madcatse/IBM-Model-H/modelh-main/site/bare_pcb.jpg

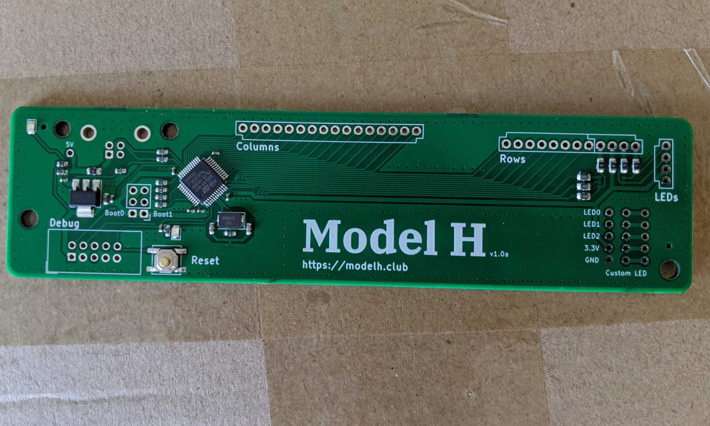
modelh-main/site/bare_pcb.jpg
