madcatse/IBM-Model-H/modelh-main/site/box_on_keyboard.jpg

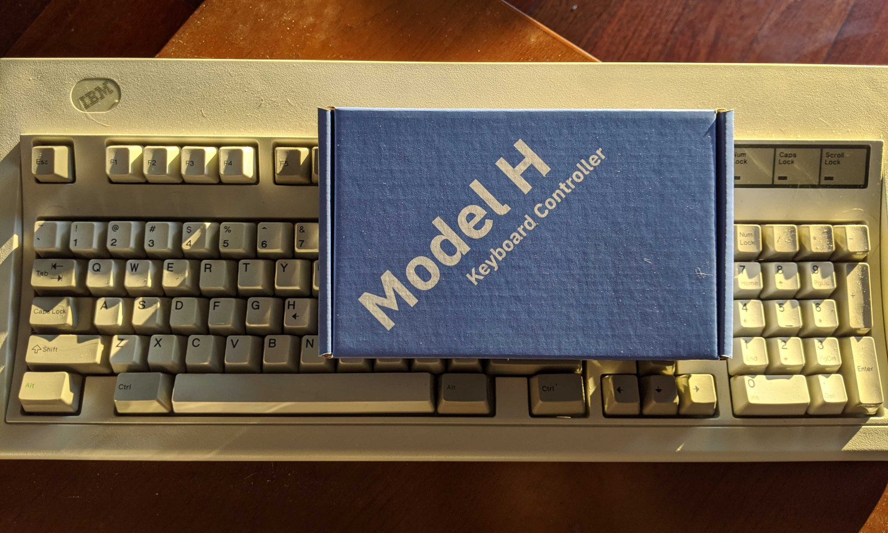
modelh-main/site/box_on_keyboard.jpg
