madcatse/IBM-Model-H/modelh-main/site/modelh_usb_back.jpg

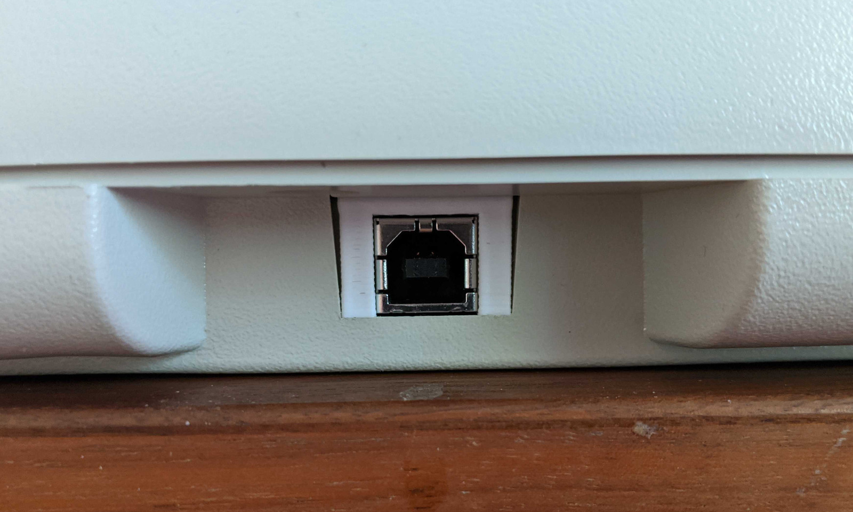
modelh-main/site/modelh_usb_back.jpg
