madcatse/IBM-Model-H/modelh-main/shim/shim.stl

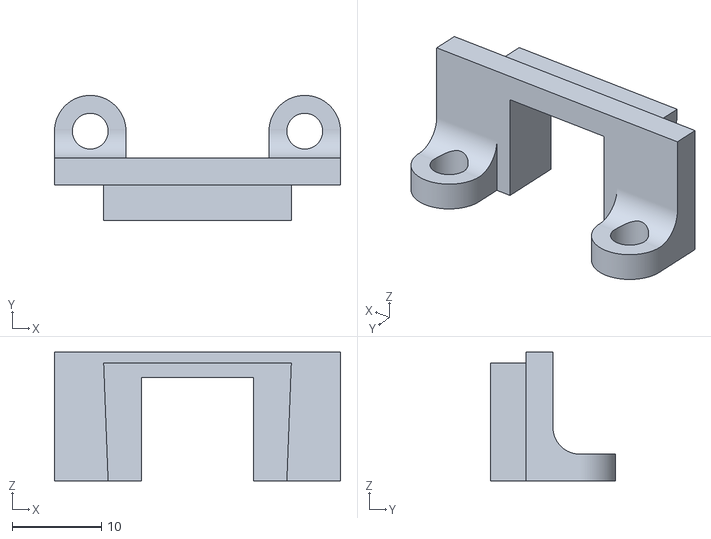
[picture p10: CAD file, 2024-10-23]
modelh-main/shim/shim.stl
32.0 x 14.0 x 14.4
