madcatse/IBM-Model-H/(list of files, cad)

Other CAD files:
modelh-main/shim/shim.scad
