madcatse/IBM-Model-H/modelh-main/pcb/modelh.kicad_pcb

## KiCad design modelh-main/pcb/modelh.kicad_pcb (2024-10-23)

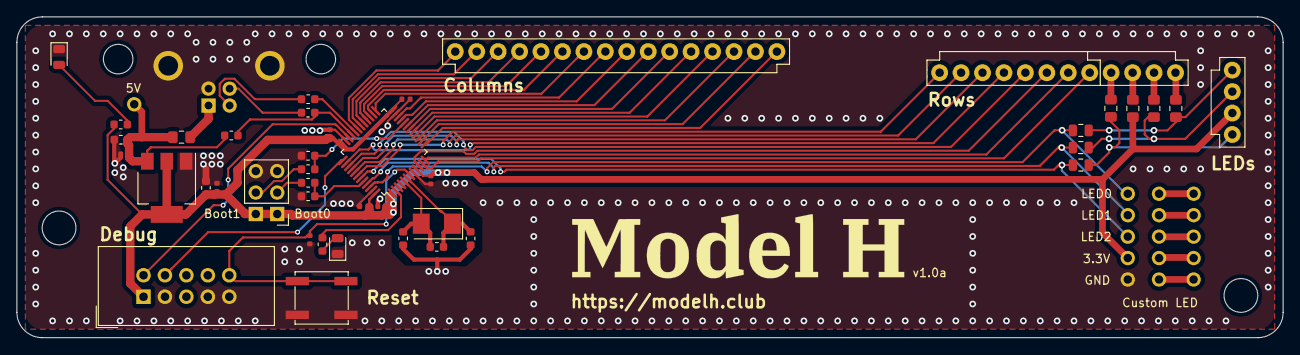
[picture p11: board modelh.kicad_pcb from above]

Board: 2 copper layers, 150.0 x 38.0 mm, 46 parts (0 on the bottom side), 59 nets.

Parts:
C1, C3: 10uF; C_0603_1608Metric
C2, C4, C9, C10, C11, C12, C13, C14: 100nF; C_0402_1005Metric
C5, C6: 20pF; C_0603_1608Metric
J1: USB_B; USB_B_OST_USB-B1HSxx_Horizontal
J2: Conn_cols; ModelH-triomate-cols16
J3: Conn_rows; ModelH-triomate-rows12
J4: Conn_leds; ModelH-tripmate-leds4
J5: Conn_02x03_Odd_Even; PinHeader_2x03_P2.54mm_Vertical
J6: Conn_02x05_Odd_Even; IDC-Header_2x05_P2.54mm_Vertical
J7, J8, J9: Conn_01x05; PinSocket_1x05_P2.54mm_Vertical
LED1, LED2: green; LED_0805_2012Metric
R1, R2: 330; R_0603_1608Metric
R3, R4: 22; R_0603_1608Metric
R5, R10, R11: 1.5k; R_0603_1608Metric
R6: 1M; R_0603_1608Metric
R7, R8, R9: 100; R_0805_2012Metric
R12, R13, R14, R15, R16: 0; R_0805_2012Metric_Pad1.15x1.40mm_HandSolder
R17, R18: 100k; R_0603_1608Metric
SW1: SW_Push; SW_SPST_EVPBF
TP1: TestPoint; TestPoint_THTPad_D1.5mm_Drill0.7mm
U1: STM32F103C8Tx; LQFP-48_7x7mm_P0.5mm
U2: AMS1117-3.3; SOT-223-3_TabPin2
Y1: 8MHz; Crystal_SMD_5032-2Pin_5.0x3.2mm

Connections:
+3V3: C3.1, C4.1, C10.1, C11.1, C12.1, C13.1, C14.1, J4.3, J5.1, J5.2, J6.1, J8.4, R1.1, R13.2, U1.1, U1.9, U1.24, U1.36, U1.48, U2.2
+5V: C1.1, C2.1, R11.2, R16.1, TP1.1, U2.3
BOOT0: R5.2, R17.1, U1.44
BOOT1: R10.1, R18.1, U1.20
D+: R3.2, R11.1, U1.33
D-: R4.2, U1.32
GND: C1.2, C2.2, C3.2, C4.2, C5.2, C6.2, C9.2, C10.2, C11.2, C12.2, C13.2, C14.2, J1.4, J1.5, J5.5, J5.6, J6.3, J6.7, J6.9, J8.5, LED1.1, LED2.1, R17.2, R18.2, SW1.1, U1.8, U1.23, U1.35, U1.47, U2.1
unnamed: J1.1, R16.2
unnamed: J1.2, R4.1
unnamed: J1.3, R3.1
unnamed: J3.9, R12.1
unnamed: J3.10, R13.1
unnamed: J3.11, R14.1
unnamed: J3.12, R15.1
unnamed: J4.1, R7.1, R15.2
unnamed: J4.2, R8.1, R14.2
unnamed: J4.4, R9.1, R12.2
unnamed: J5.3, R5.1
unnamed: J5.4, R10.2
unnamed: J7.1, J9.1
unnamed: J7.2, J9.2
unnamed: J7.3, J9.3
unnamed: J7.4, J9.4
unnamed: J7.5, J9.5
unnamed: LED1.2, R1.2
unnamed: LED2.2, R2.2
OSC8IN: C5.1, R6.1, U1.6, Y1.1
OSC8OUT: C6.1, R6.2, U1.5, Y1.2
STATUSLED: R2.1, U1.2
SWCLK: J6.4, U1.37
SWDIO: J6.2, U1.34
col0: J2.1, U1.31
col1: J2.2, U1.30
col2: J2.3, U1.29
col3: J2.4, U1.28
col4: J2.5, U1.27
col5: J2.6, U1.26
col6: J2.7, U1.25
col7: J2.8, U1.22
col8: J2.9, U1.21
col9: J2.10, U1.19
col10: J2.11, U1.18
col11: J2.12, U1.17
col12: J2.13, U1.16
col13: J2.14, U1.15
col14: J2.15, U1.14
col15: J2.16, U1.13
led0: J8.1, R7.2, U1.46
led1: J8.2, R8.2, U1.45
led2: J8.3, R9.2, U1.43
nRST: C9.1, J6.10, SW1.2, U1.7
row0: J3.1, U1.42
row1: J3.2, U1.41
row2: J3.3, U1.40
row3: J3.4, U1.38
row4: J3.5, U1.39
row5: J3.6, U1.10
row6: J3.7, U1.12
row7: J3.8, U1.11
