madcatse/IBM-Model-H/modelh-main/site/modelh_assembled.jpg

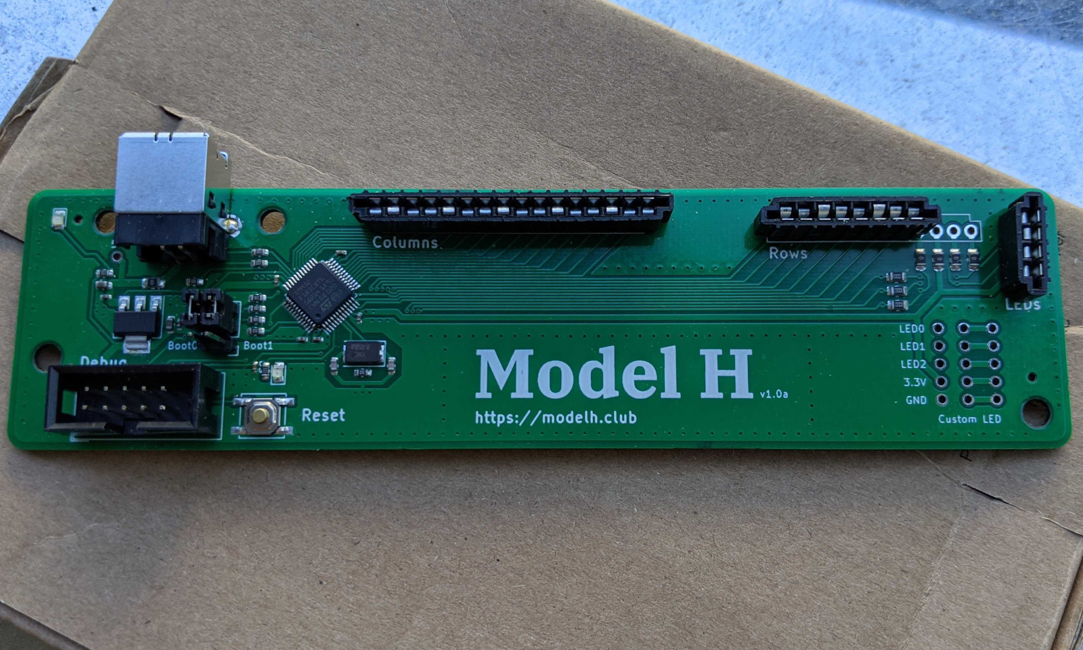
modelh-main/site/modelh_assembled.jpg
