madcatse/IBM-Model-H/modelh-main/site/modelh_installed.jpg

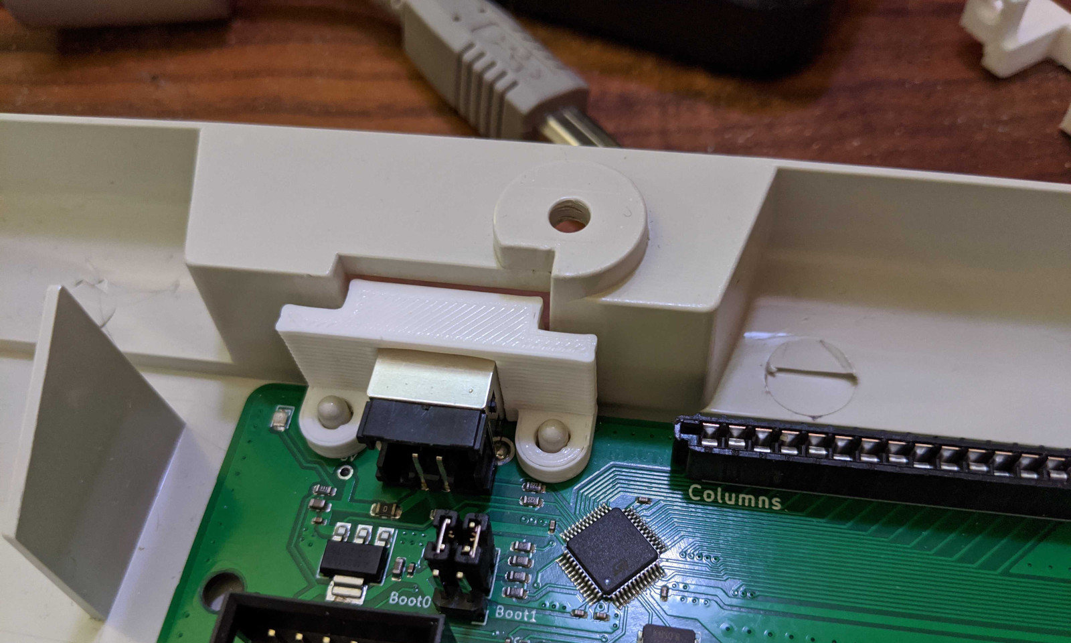
modelh-main/site/modelh_installed.jpg
